mmpdwybzdjsm/Hardware-For-SmartCar/硬件/硬件——大松的板子/主控1/Board Information - DS_zk.txt

Board Information Report
Filename     : E:\ProjectFile\ADFile\晴雪\主控\DS_zk.1.PcbDoc
Date         : 2017/12/29
Time         : 23:25:34
Time Elapsed : 00:00:00

Routing Information
    Routing completion, 100.00%
    Connections, 198
    Connections routed, 198
    Connections remaining, 0
count : 4
