mmpdwybzdjsm/Hardware-For-SmartCar/硬件/抄板——王昊/王昊_PCB.pdf

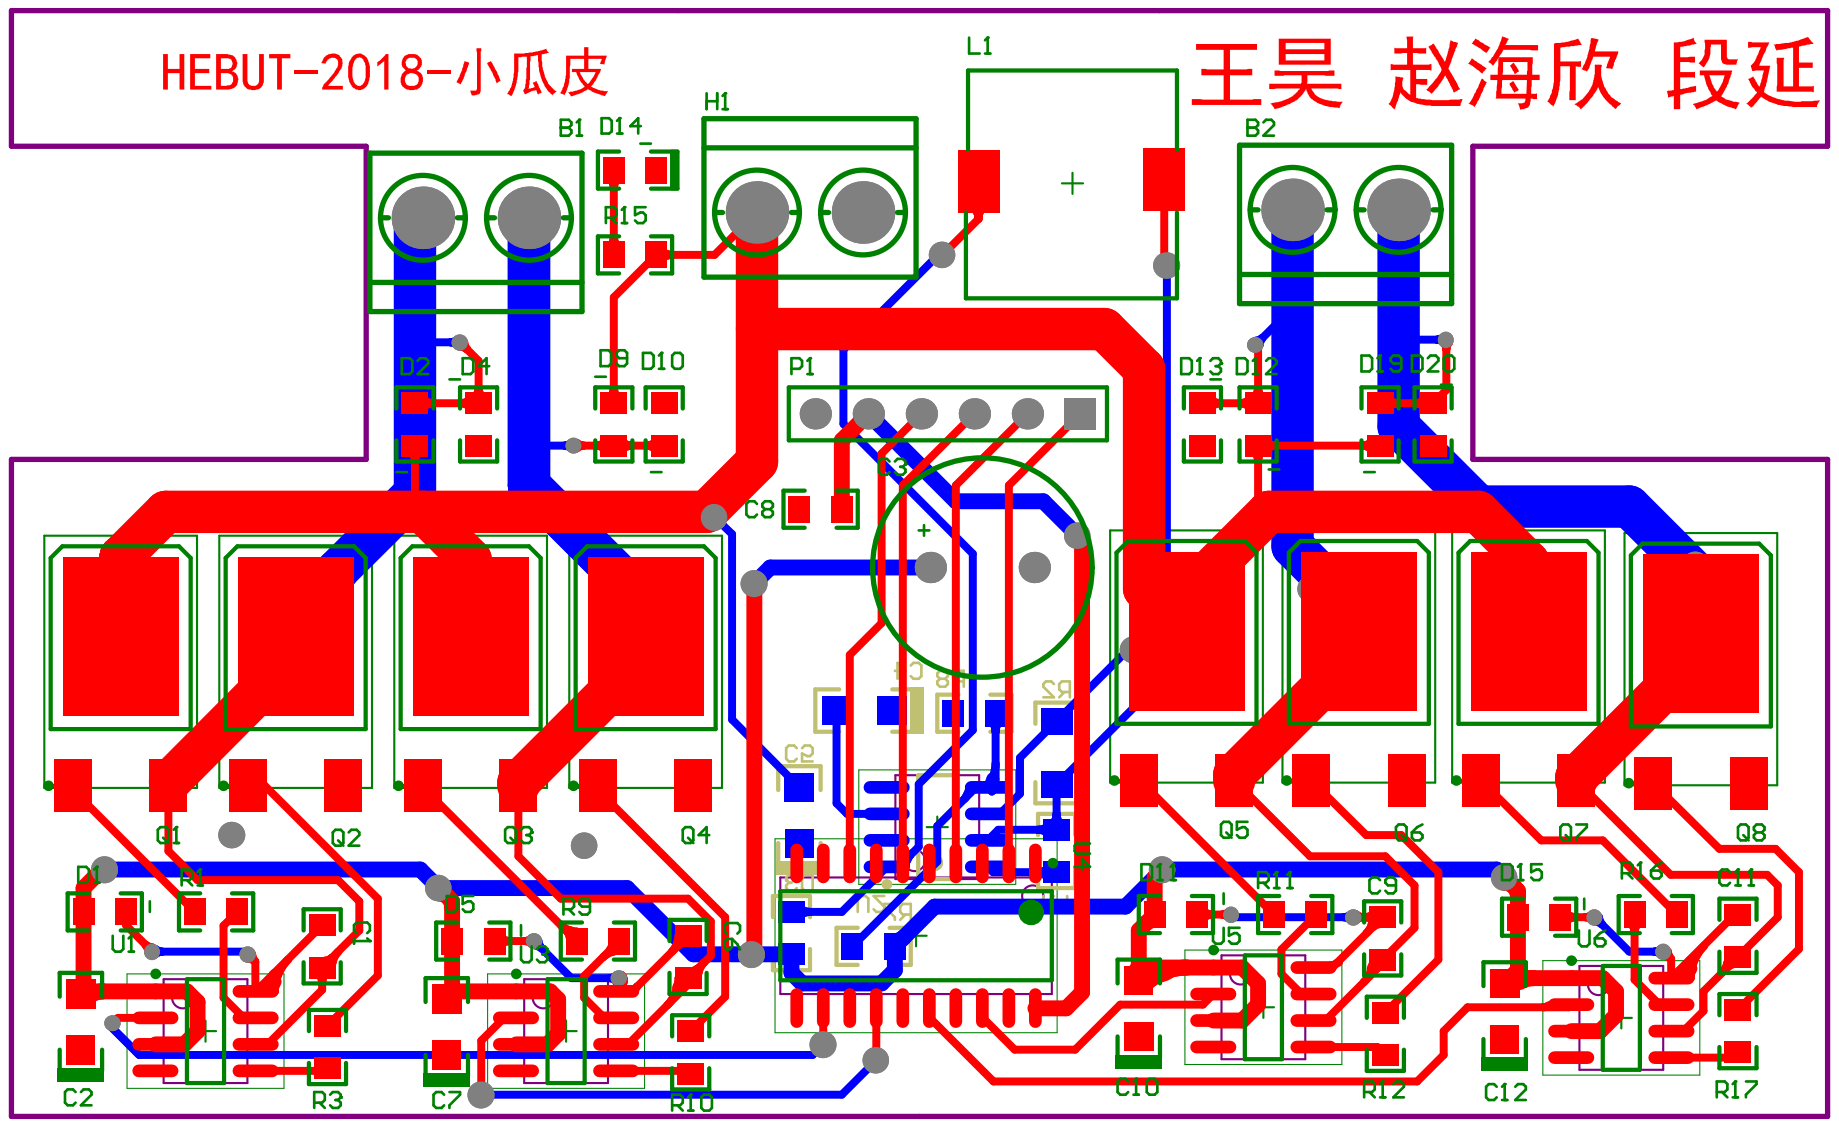
[picture p106: page 1]
