mmpdwybzdjsm/Hardware-For-SmartCar/硬件/硬件——大松的板子/主控3/20180616.pdf

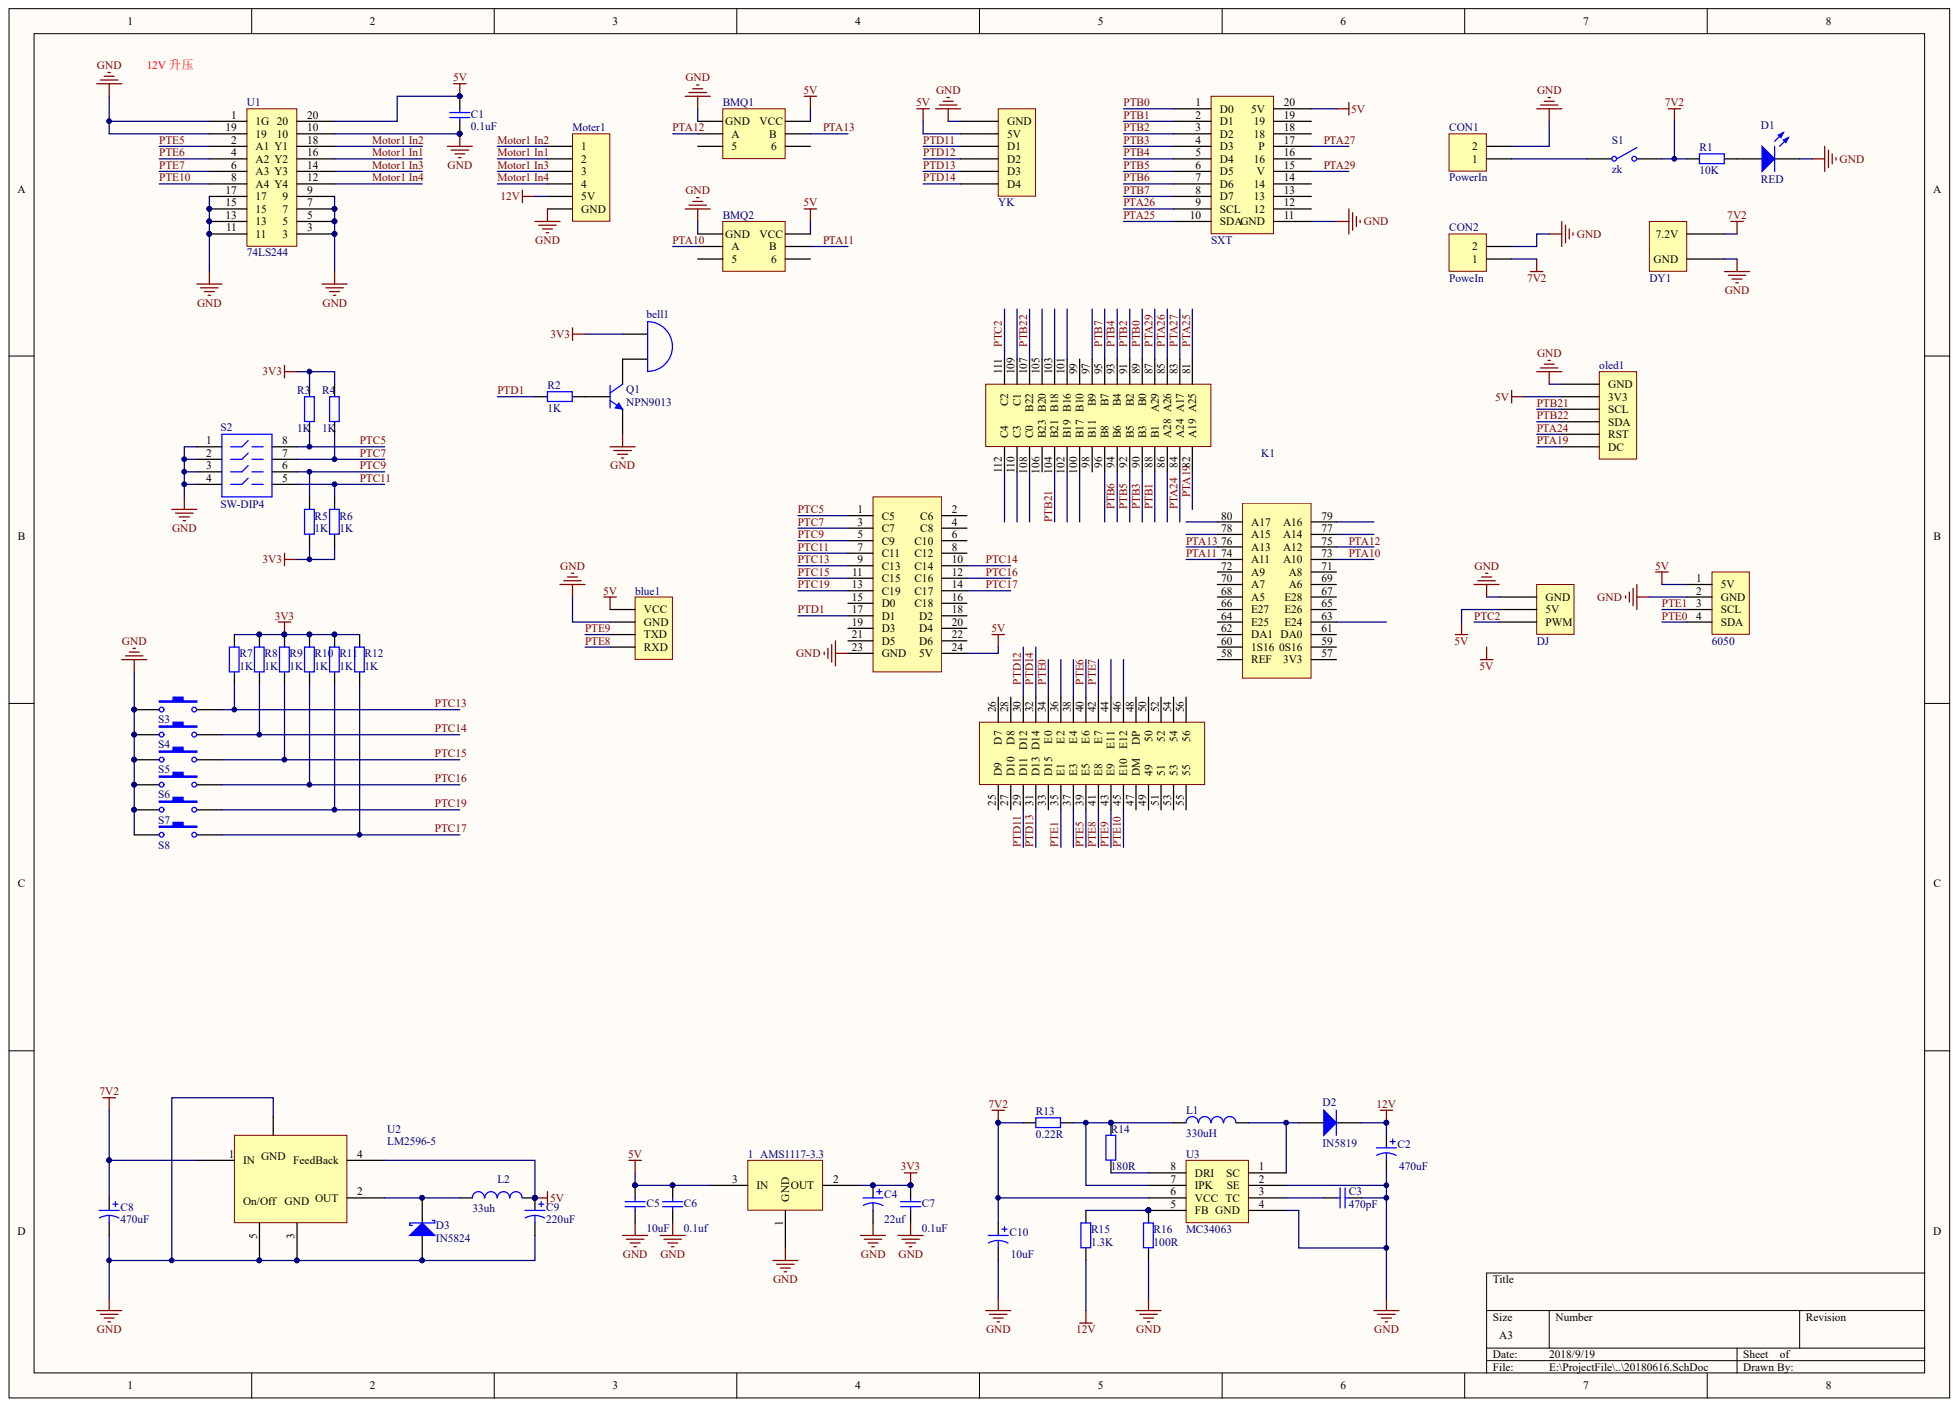
[picture p107: page 1]

2 | 7 | PTC7
3 | 6 PTC9
4 | 5 | PTC11

PTC15

PTC16

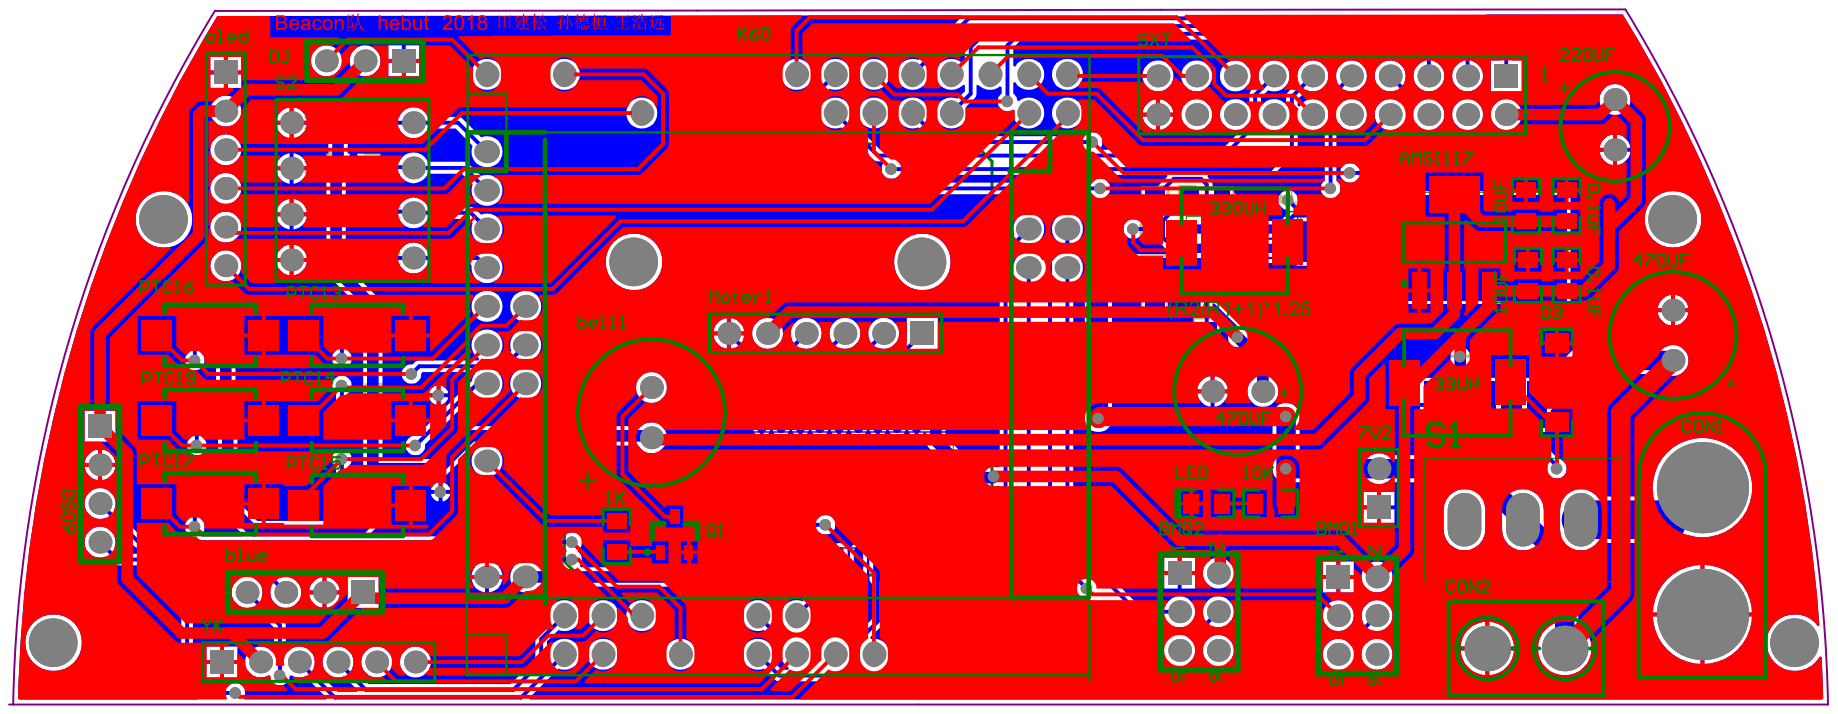
[picture p108: page 2]
