mmpdwybzdjsm/Hardware-For-SmartCar/硬件/硬件——大松的板子/驱动/mos驱动PCB图.pdf

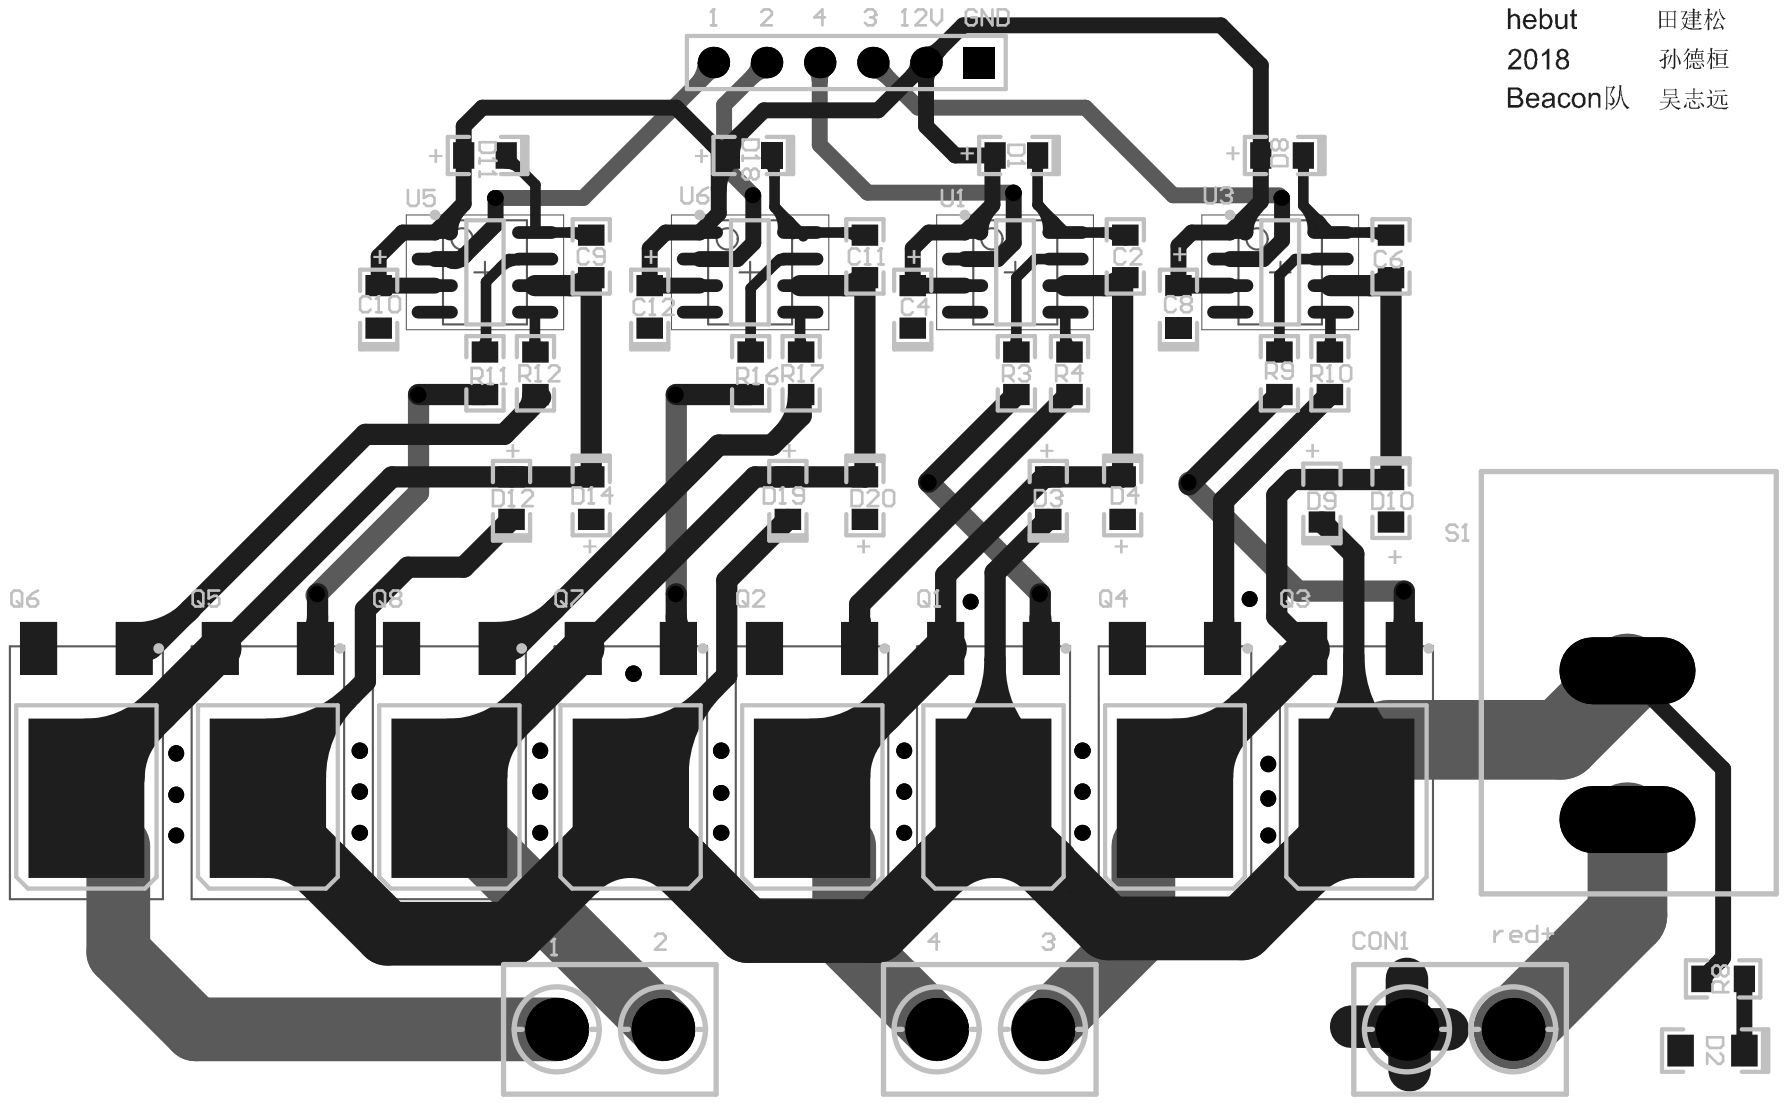
[picture p109: page 1]
