mmpdwybzdjsm/Hardware-For-SmartCar/硬件/硬件——大松的板子/驱动/mos驱动原理图.pdf

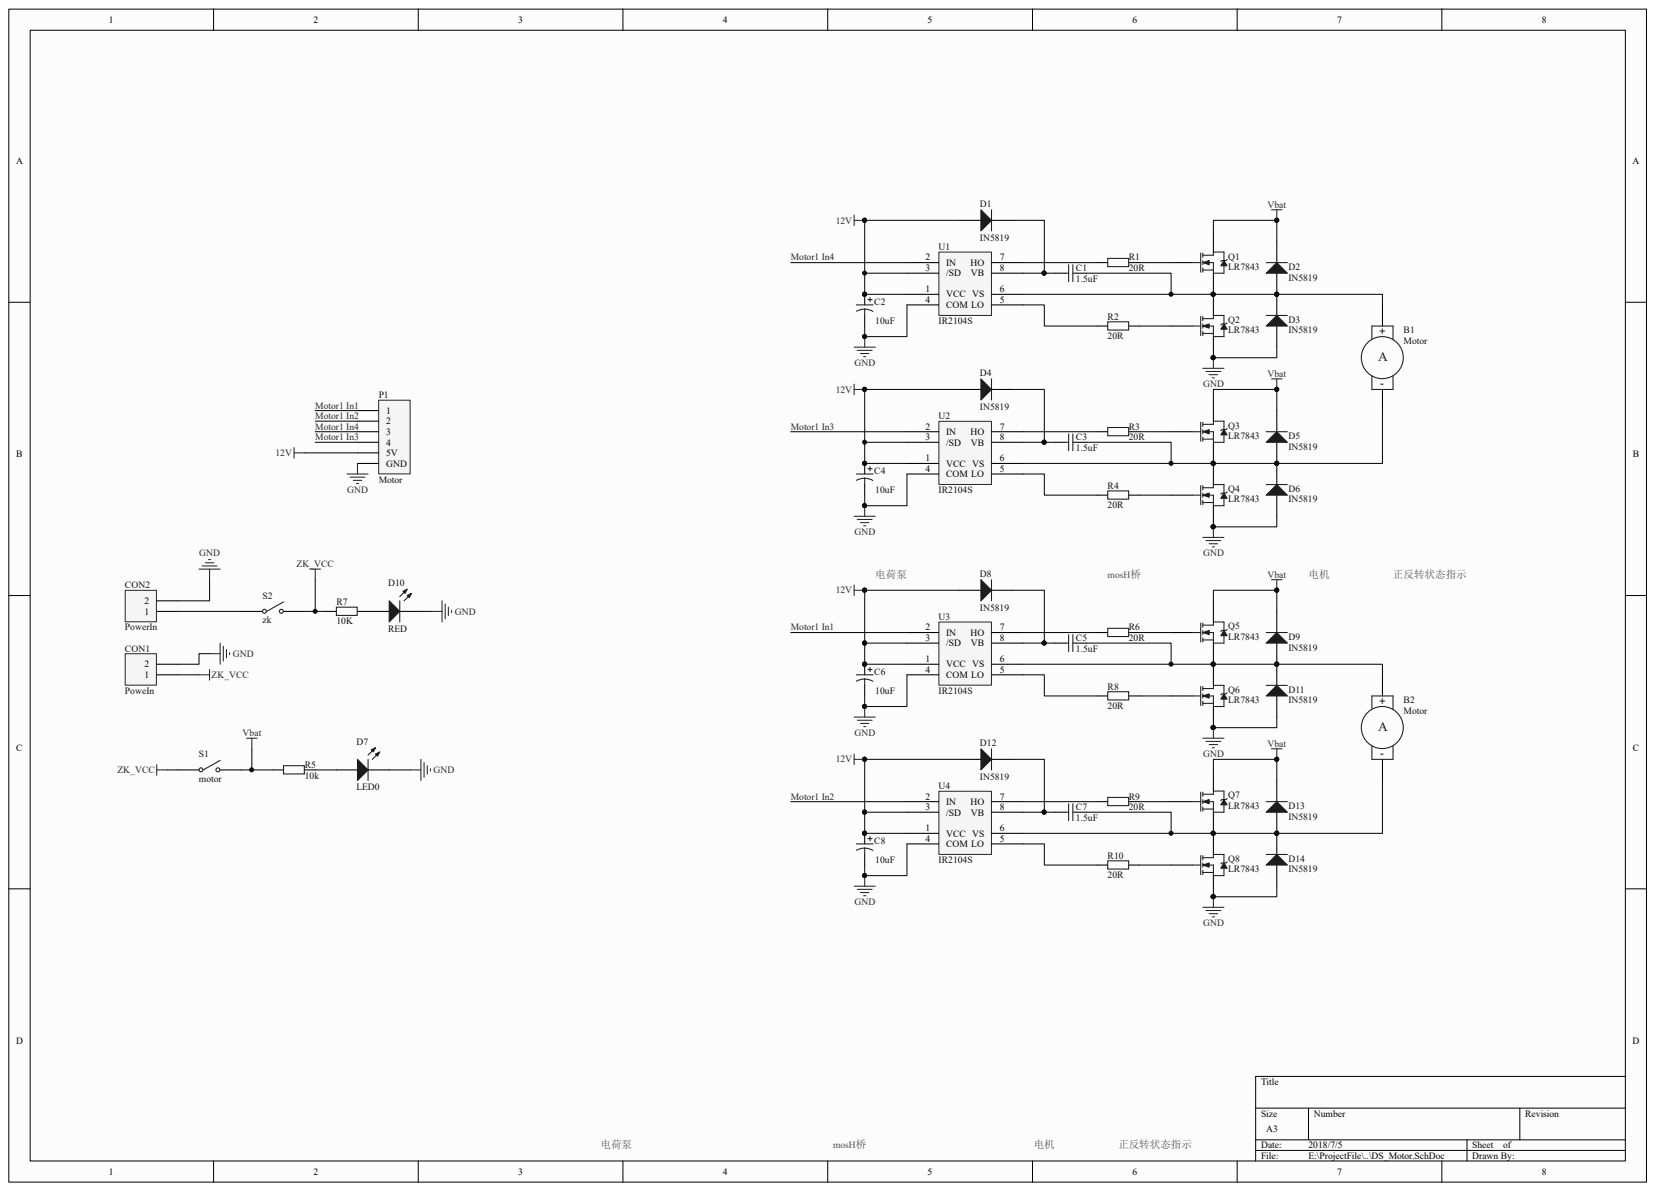
[picture p110: page 1]
