mmpdwybzdjsm/Hardware-For-SmartCar/(list of files, drawings)

Other design files:
硬件/Altium Designer 3D元件库LMDZ16/74系列芯片.SchLib
硬件/Altium Designer 3D元件库LMDZ16/9001连接器.PcbLib
硬件/Altium Designer 3D元件库LMDZ16/Atmel系列单片机.SchLib
硬件/Altium Designer 3D元件库LMDZ16/CD系列芯片.SchLib
硬件/Altium Designer 3D元件库LMDZ16/FPC1.0.PcbLib
硬件/Altium Designer 3D元件库LMDZ16/FPC连接器.SchLib
硬件/Altium Designer 3D元件库LMDZ16/IC芯片.SchLib
硬件/Altium Designer 3D元件库LMDZ16/KF接线端子.PcbLib
硬件/Altium Designer 3D元件库LMDZ16/LED.SchLib
硬件/Altium Designer 3D元件库LMDZ16/LOGO.PcbLib
硬件/Altium Designer 3D元件库LMDZ16/MSOP.PcbLib
硬件/Altium Designer 3D元件库LMDZ16/MX1.25.PcbLib
硬件/Altium Designer 3D元件库LMDZ16/PHB2.0.PcbLib
硬件/Altium Designer 3D元件库LMDZ16/PHD2.0.PcbLib
硬件/Altium Designer 3D元件库LMDZ16/QFN.PcbLib
硬件/Altium Designer 3D元件库LMDZ16/SOT.PcbLib
硬件/Altium Designer 3D元件库LMDZ16/SSOP.PcbLib
硬件/Altium Designer 3D元件库LMDZ16/STC系列单片机.SchLib
硬件/Altium Designer 3D元件库LMDZ16/STM8系列单片机.SchLib
硬件/Altium Designer 3D元件库LMDZ16/STM32系列单片机.SchLib
硬件/Altium Designer 3D元件库LMDZ16/TSSOP.PcbLib
硬件/Altium Designer 3D元件库LMDZ16/TX1.25.PcbLib
硬件/Altium Designer 3D元件库LMDZ16/VH3.96.PcbLib
硬件/Altium Designer 3D元件库LMDZ16/三极管.SchLib
硬件/Altium Designer 3D元件库LMDZ16/二极管-整流桥.SchLib
硬件/Altium Designer 3D元件库LMDZ16/传感元件.PcbLib
硬件/Altium Designer 3D元件库LMDZ16/传感元件.SchLib
硬件/Altium Designer 3D元件库LMDZ16/保险丝-晶振.SchLib
硬件/Altium Designer 3D元件库LMDZ16/保险丝.PcbLib
硬件/Altium Designer 3D元件库LMDZ16/压敏电阻.PcbLib
硬件/Altium Designer 3D元件库LMDZ16/变压器.PcbLib
硬件/Altium Designer 3D元件库LMDZ16/变压器.SchLib
硬件/Altium Designer 3D元件库LMDZ16/合泰单片机.SchLib
硬件/Altium Designer 3D元件库LMDZ16/场效应管-可控硅.SchLib
硬件/Altium Designer 3D元件库LMDZ16/天线.PcbLib
硬件/Altium Designer 3D元件库LMDZ16/开关.PcbLib
硬件/Altium Designer 3D元件库LMDZ16/按键-开关.SchLib
硬件/Altium Designer 3D元件库LMDZ16/排针-排母.PcbLib
硬件/Altium Designer 3D元件库LMDZ16/接口类.SchLib
硬件/Altium Designer 3D元件库LMDZ16/接插件.SchLib
硬件/Altium Designer 3D元件库LMDZ16/显示器件.SchLib
硬件/Altium Designer 3D元件库LMDZ16/晶振.PcbLib
硬件/Altium Designer 3D元件库LMDZ16/未分类器件.PcbLib
硬件/Altium Designer 3D元件库LMDZ16/未分类器件.SchLib
硬件/Altium Designer 3D元件库LMDZ16/模块.SchLib
硬件/Altium Designer 3D元件库LMDZ16/电源接口.PcbLib
硬件/Altium Designer 3D元件库LMDZ16/电阻-电容-电感.SchLib
硬件/Altium Designer 3D元件库LMDZ16/继电器.SchLib
硬件/Altium Designer 3D元件库LMDZ16/音频接口.PcbLib
硬件/主控+驱动（还没搞完）/主控＋驱动.PrjPCB
硬件/主控+驱动（还没搞完）/驱动原理图.SchDoc
硬件/主控+驱动（还没搞完）/驱动板PCB1.PcbDoc
硬件/抄板——夏宇/driver_T_1.SchDoc
硬件/抄板——夏宇/IR2104S.PcbLib
硬件/抄板——夏宇/IR2104S.SchLib
硬件/抄板——夏宇/LY.PcbLib
硬件/抄板——夏宇/LY.SchLib
硬件/抄板——夏宇/PCB1.PcbDoc
硬件/抄板——夏宇/驱动1.PcbLib
硬件/抄板——大松/wzy_PCB.PcbDoc
硬件/抄板——大松/wzy_SCH.SchDoc
硬件/抄板——大松/大松_PcbLib1.PcbLib
硬件/抄板——大松/大松_Schlib1.SchLib
硬件/抄板——大松/大松PCB1.PcbDoc
硬件/抄板——大松/驱动.SchDoc
硬件/抄板——大松/驱动_PCB_Project1.PrjPCB
硬件/抄板——李扬第一版/IR2104S.PcbLib
硬件/抄板——李扬第一版/IR2104S.SchLib
硬件/抄板——李扬第一版/LY.PcbLib
硬件/抄板——李扬第一版/LY.SchLib
硬件/抄板——李扬第一版/motor.SchDoc
硬件/抄板——李扬第一版/PCB1.PcbDoc
硬件/抄板——李扬第一版/PCB2.PcbDoc
硬件/抄板——李扬第一版/PCB_Project1.PrjPCB
硬件/抄板——李扬第一版/PcbLib1.PcbLib
硬件/抄板——李扬第一版/Schlib1.SchLib
硬件/抄板——李扬第一版/Sheet1.SchDoc
硬件/抄板——李扬第一版/抄板——李扬/IR2104S.PcbLib
硬件/抄板——李扬第一版/抄板——李扬/IR2104S.SchLib
硬件/抄板——李扬第一版/抄板——李扬/LY.PcbLib
硬件/抄板——李扬第一版/抄板——李扬/LY.SchLib
硬件/抄板——李扬第一版/抄板——李扬/PCB1.PcbDoc
硬件/抄板——李扬第一版/抄板——李扬/PCB_Project1.PrjPCB
硬件/抄板——李扬第一版/抄板——李扬/PcbLib1.PcbLib
硬件/抄板——李扬第一版/抄板——李扬/Schlib1.SchLib
硬件/抄板——李扬第一版/抄板——李扬/Sheet1.SchDoc
硬件/抄板——李扬第一版/王昊_PCB.PcbLib
硬件/抄板——李扬第一版/驱动1.PcbDoc
硬件/抄板——李扬第二版/IR2104S.SchLib
硬件/抄板——李扬第二版/LY.SchLib
硬件/抄板——李扬第二版/PCB_Project1.PrjPCB
硬件/抄板——李扬第二版/PcbLib1.PcbLib
硬件/抄板——李扬第二版/Sheet1.SchDoc
硬件/抄板——李扬第二版/李扬1.SchDoc
硬件/抄板——王昊/驱动原理图.SchDoc
硬件/硬件——大松的板子/DS_Lib.PcbLib
硬件/硬件——大松的板子/主控1/DS_zk.PcbDoc
硬件/硬件——大松的板子/主控1/DS_zk.PrjPCB
硬件/硬件——大松的板子/主控1/DS_zk.SchDoc
硬件/硬件——大松的板子/主控1/DS_zk.SCHLIB
硬件/硬件——大松的板子/主控1/DS_zk.~(57).PcbDoc
硬件/硬件——大松的板子/主控1/DS_ZK_2.0.PcbDoc
硬件/硬件——大松的板子/主控1/DS_ZK_FINAL.SchDoc
硬件/硬件——大松的板子/主控2/ai.PrjPCB
硬件/硬件——大松的板子/主控2/ai.SchDoc
硬件/硬件——大松的板子/主控3/20180616.PcbLib
硬件/硬件——大松的板子/主控3/20180616.PrjPCB
硬件/硬件——大松的板子/主控3/20180616.SchDoc
硬件/硬件——大松的板子/主控3/20180616.SchLib
硬件/硬件——大松的板子/主控4/20180623.PcbDoc
硬件/硬件——大松的板子/主控4/20180623.SchDoc
硬件/硬件——大松的板子/驱动/DS_Motor1.0.PcbDoc
硬件/硬件——大松的板子/驱动/DS_Motor.PcbDoc
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
