mmpdwybzdjsm/Hardware-For-SmartCar/(commit log)

2018-10-06 Hardware Designed For Smartcar
    [20180616.PcbLib, 20180616.PrjPCB, 20180616.SchDoc, 20180616.SchLib, 20180623.PcbDoc, 20180623.SchDoc, 74系列芯片.SchLib, 9001连接器.PcbLib]
2018-10-06 Change +- for Diode
    [wzy_PCB1_01.PcbDoc]
